revk/ESP32-IronMan/PCB/README.md

# PCBs for IronMan Suit

## Controller

Controller board

- Four LED driver outputs
- Two button inputs
- Stereo speaker outputs
- Stereo microphone (not needed for IronMan suit)
- Micro SD card slot
- On board LED
