revk/ESP32-IronMan/PCB/IronMan/README.md

# IronMan

These files are for use in [KiCad](https://www.kicad.org).

## Trademark

This is an open source project, but bear in mind you cannot sell boards bearing the Andrews & Arnold Ltd name, the A&A logo, the registered trademark AJK logo, or the GS1 allocated EANs assigned to Andrews & Arnold Ltd.

## Images

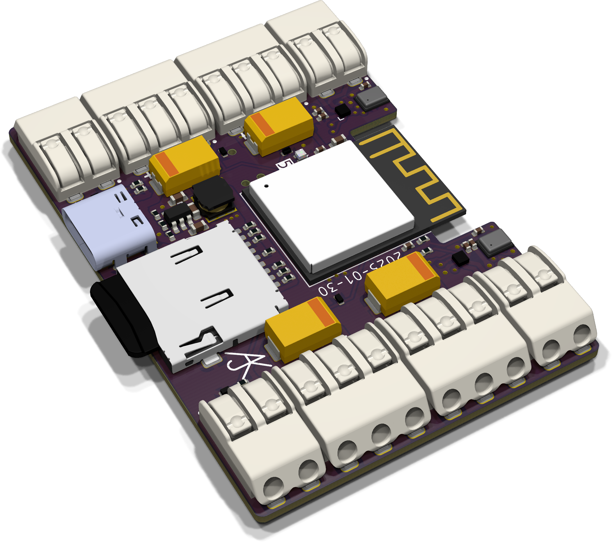
[picture p5: PCB/IronMan/IronMan-90.png]

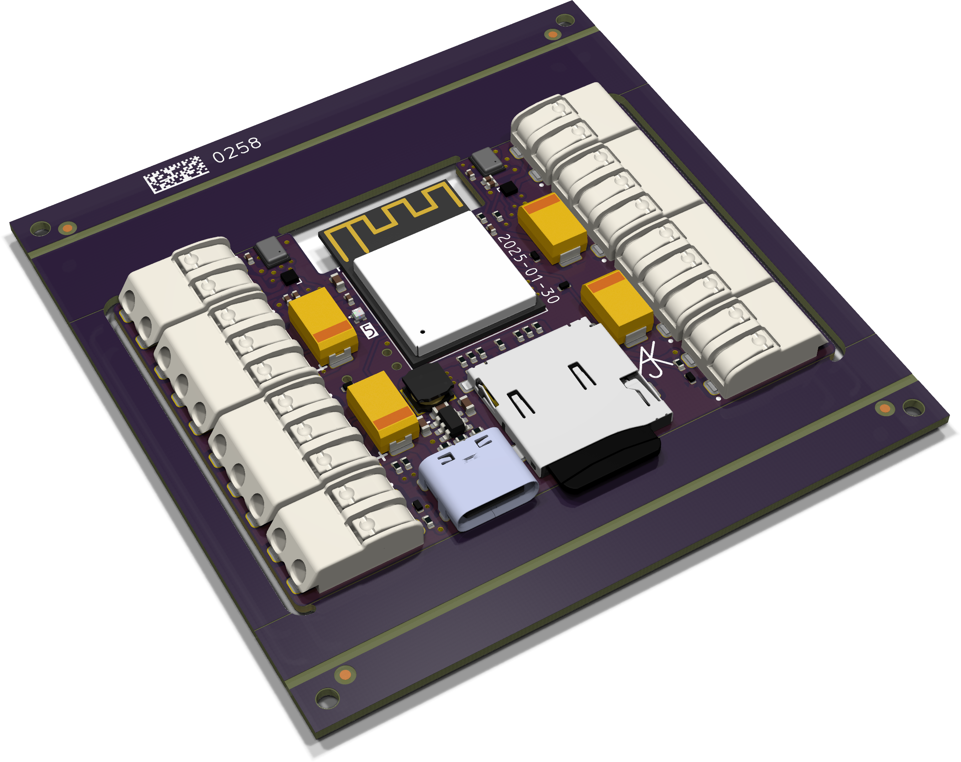
[picture p6: PCB/IronMan/IronMan-panel.png]
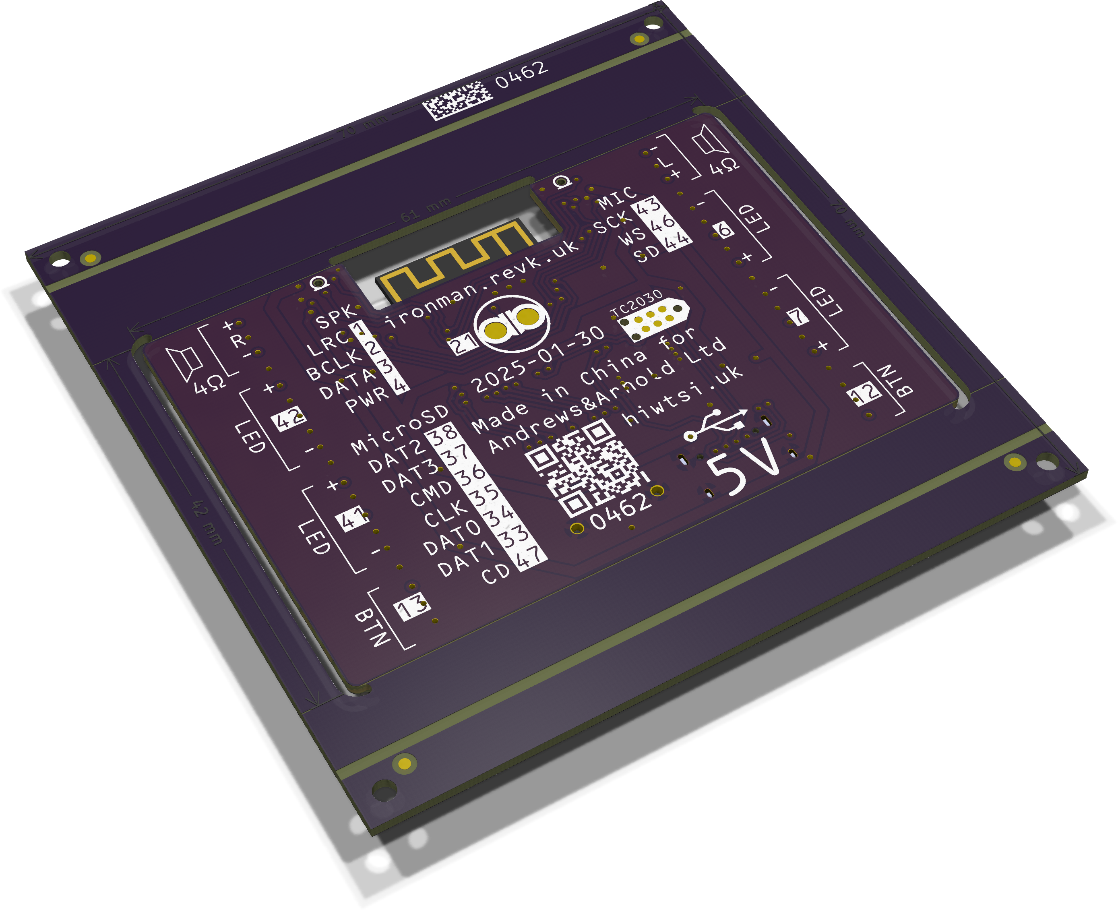
[picture p7: PCB/IronMan/IronMan-panel-bottom.png]


*Auto generated 2025-01-30T09:48:34*
