revk/ESP32-IronMan/PCB/Glove/README.md

# Glove

These files are for use in [KiCad](https://www.kicad.org).

## Trademark

This is an open source project, but bear in mind you cannot sell boards bearing the Andrews & Arnold Ltd name, the A&A logo, the registered trademark AJK logo, or the GS1 allocated EANs assigned to Andrews & Arnold Ltd.

## Images

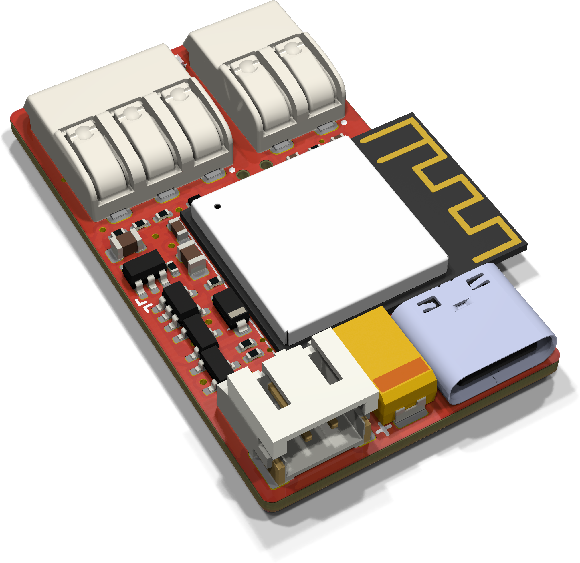
[picture p8: PCB/Glove/Glove-90.png]

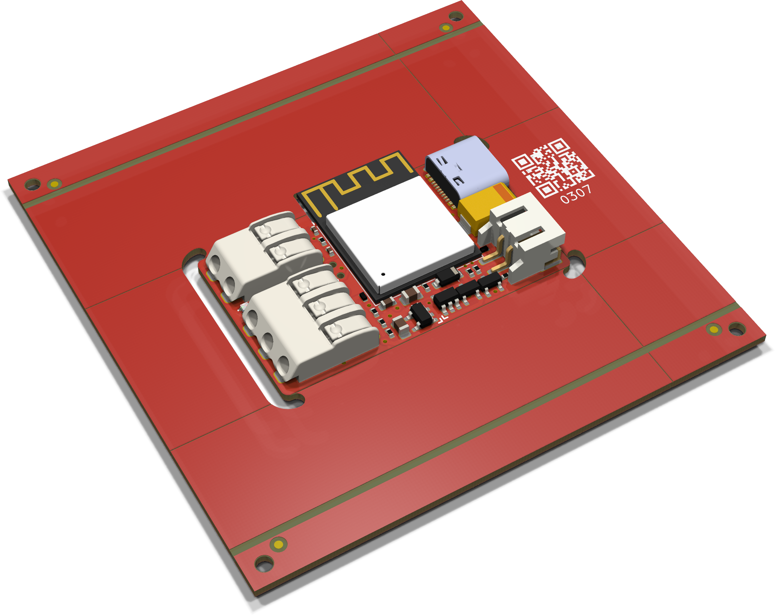
[picture p9: PCB/Glove/Glove-panel.png]
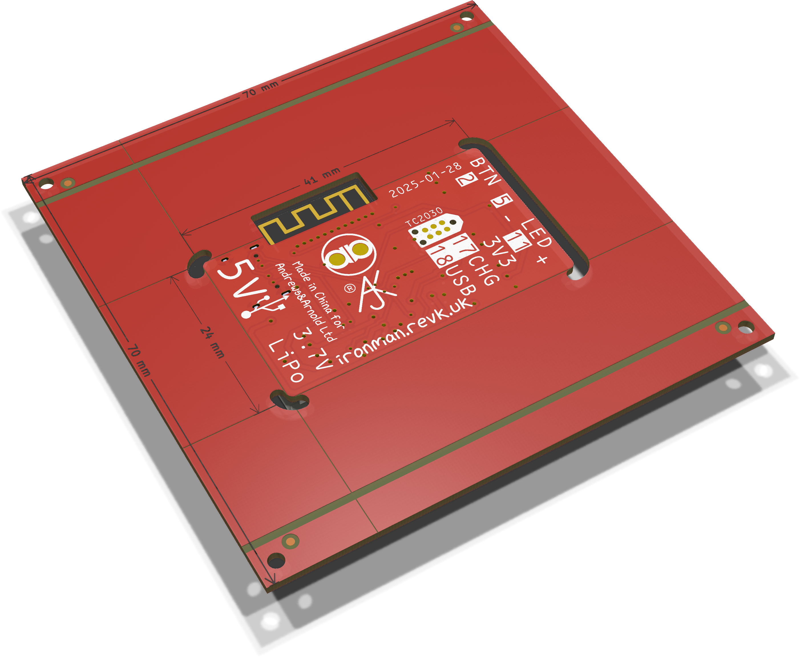
[picture p10: PCB/Glove/Glove-panel-bottom.png]


*Auto generated 2025-01-28T13:22:18*
