revk/ESP32-IronMan/PCB/IronMan/IronMan.stl

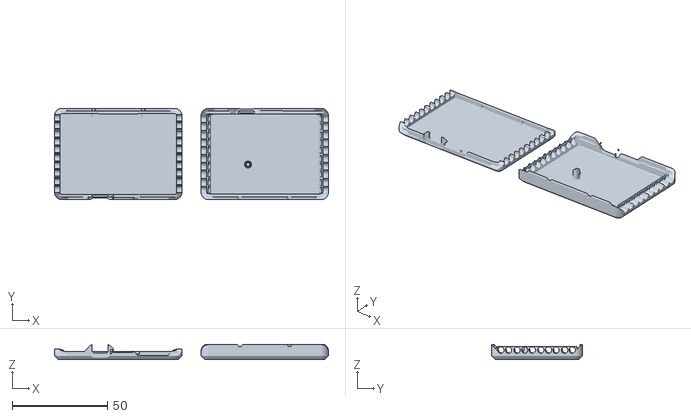
[picture p11: CAD file, 2025-01-13]
PCB/IronMan/IronMan.stl
144.0 x 48.0 x 7.99
