revk/ESP32-IronMan/PCB/Glove/Glove.kicad_pcb

## KiCad design PCB/Glove/Glove.kicad_pcb (2026-02-13)

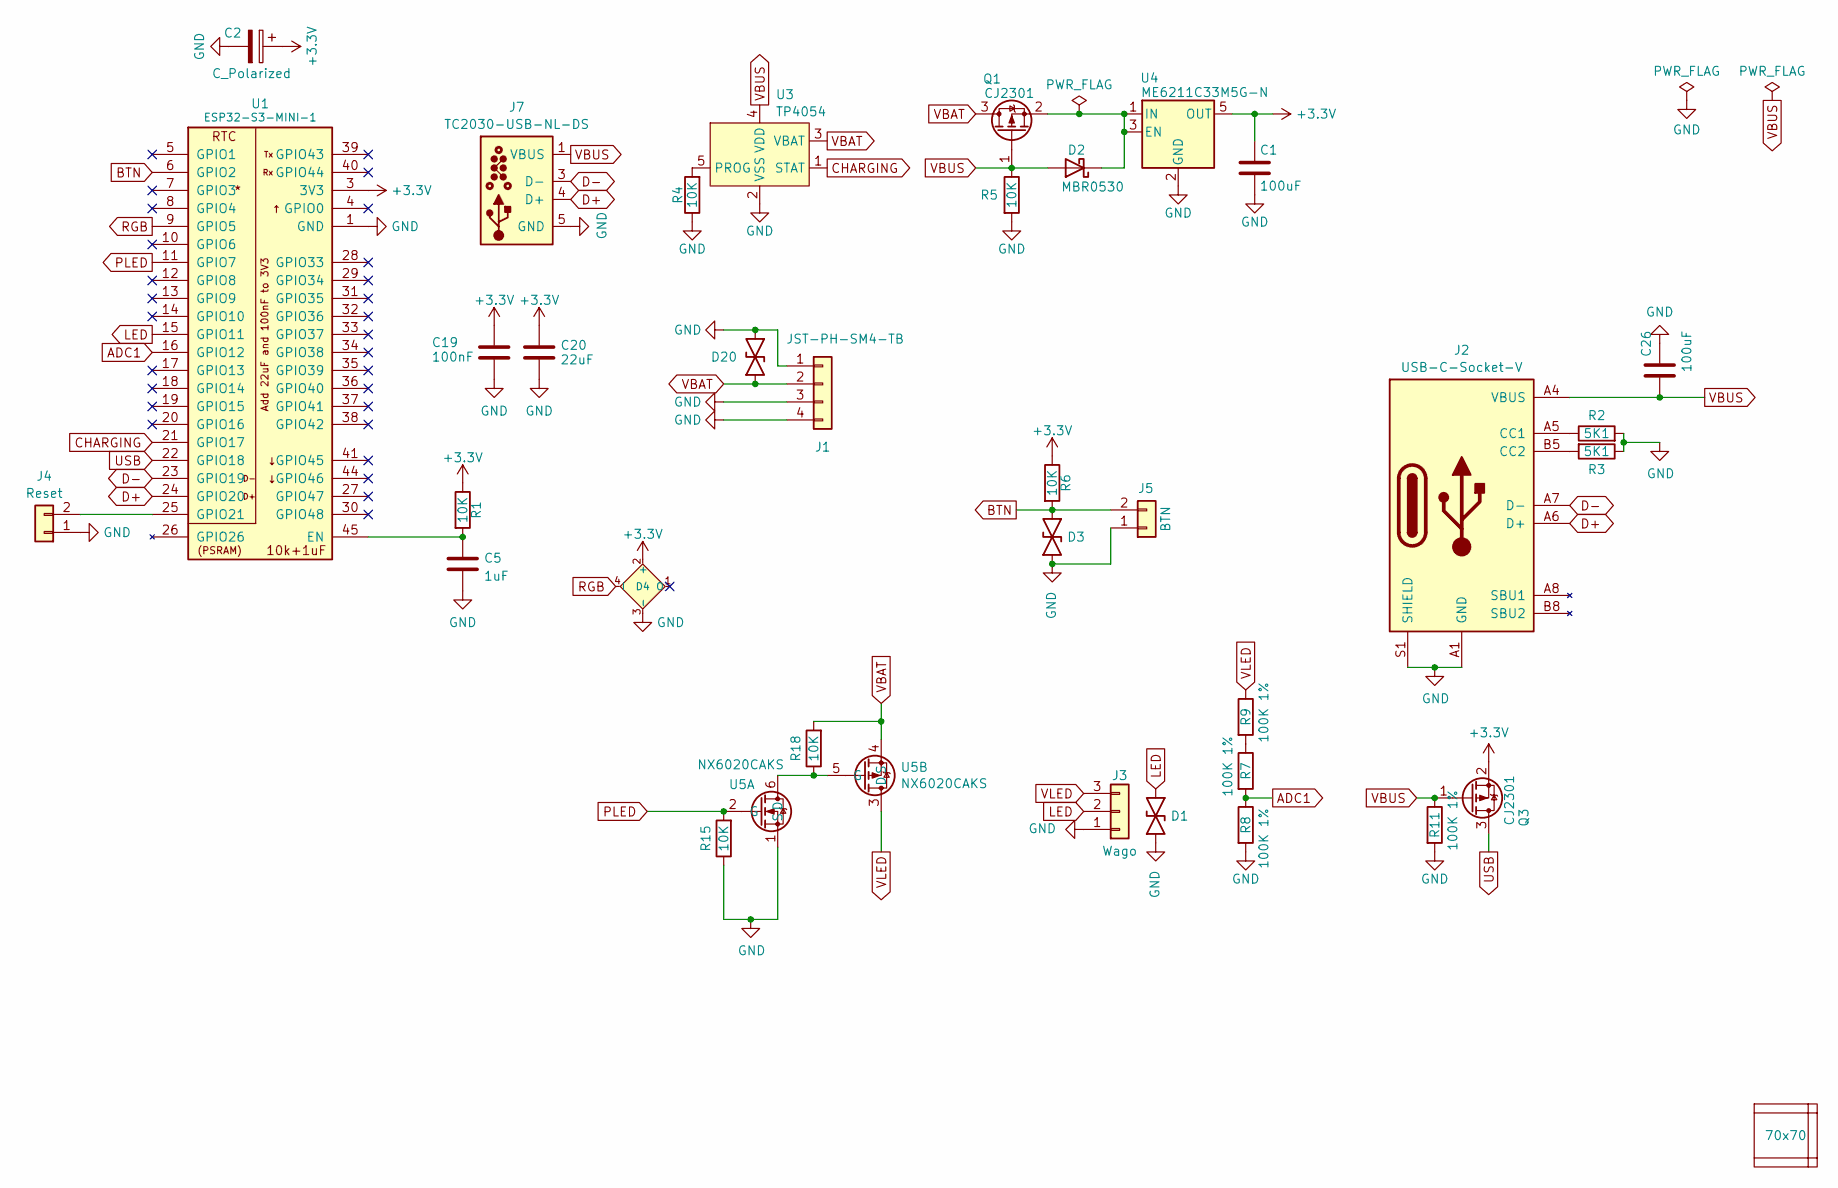
[picture p12: schematic Glove.kicad_sch, GPS reference]

Parts:
C1, C26: 100uF; C_0805; MPN C141660
C2: C_Polarized; CP_EIA-7343-31_Kemet-D; MPN C106188
C5: 1uF; C_0402
C19: 100nF; C_0402
C20: 22uF; C_0603
D1, D3, D20: DFN1006-2L; MPN C5137770
D2: MBR0530; D_SOD-123; MPN C5204746
D4: XL-1010RGBC-WS2812B; SMD1010; MPN C5349953
J1: JST-PH-SM4-TB; JST_PH_S2B-PH-SM4-TB_1x02-1MP_P2.00mm_Horizontal; MPN C295747
J2: USB-C-Socket-V; USB-C-Socket-H; MPN C709357
J3: Wago; WAGO-2060-453-998-404; MPN C2765056
J4: Reset; AA-Pad
J5: BTN; WAGO-2060-452-998-404; MPN C2765055
J7: TC2030-USB-NL-DS; Tag-Connect_TC2030-IDC-NL_2x03_P1.27mm_Vertical
PCB1: 70x70; PCB7070
Q1, Q3: CJ2301; SOT-23; MPN C5224170
R1, R4, R5, R6, R15, R18: 10K; R_0402
R2, R3: 5K1; R_0402
R7, R8, R9, R11: 100K 1%; R_0402; MPN C5139597
U1: ESP32-S3-MINI-1; MPN C3013941
U3: TP4054; SOT-23-5; MPN C668215
U4: ME6211C33M5G-N; SOT-23-5; MPN C82942
U5: NX6020CAKS; SOT-363_SC-70-6
V1, V2, V4: VCUT70N

Connections:
+3.3V: C1.1, C2.1, C19.1, C20.1, D4.2 (+), Q3.2 (S), R1.1, R6.1, U1.3 (3V3), U4.5 (OUT)
ADC1: R7.2, R8.1, U1.16 (GPIO12)
BTN: D3.2, J5.2, R6.2, U1.6 (GPIO2)
CHARGING: U1.21 (GPIO17), U3.1 (STAT)
D+: J2.A6 (D+), J2.B6 (D+), J7.4 (D+), U1.24 (GPIO20)
D-: J2.A7 (D-), J2.B7 (D-), J7.2 (NC), J7.3 (D-), J7.6 (NC), U1.23 (GPIO19)
GND: C1.2, C2.2, C5.2, C19.2, C20.2, C26.2, D1.1, D3.1, D4.3 (-), D20.1, J1.1, J1.3, J1.4, J2.A1 (GND), J2.A12 (GND), J2.B1 (GND), J2.B12 (GND), J2.S1 (SHIELD), J3.1, J4.1, J5.1, J7.5 (GND), R2.2, R3.1, R4.1, R5.2, R8.2, R11.2, R15.1, U1.1 (GND), U1.2 (GND), U1.42 (GND), U1.43 (GND), U1.46 (GND), U1.47 (GND), U1.48 (GND), U1.49 (GND), U1.50 (GND), U1.51 (GND), U1.52 (GND), U1.53 (GND), U1.54 (GND), U1.55 (GND), U1.56 (GND), U1.57 (GND), U1.58 (GND), U1.59 (GND), U1.60 (GND), U1.61 (GND), U1.62 (GND), U1.63 (GND), U1.64 (GND), U1.65 (GND), U3.2 (VSS), U4.2 (GND), U5.1 (S)
LED: D1.2, J3.2, U1.15 (GPIO11)
unnamed: D2.1 (K), Q1.2 (S), U4.1 (IN), U4.3 (EN)
unnamed: J2.A5 (CC1), R2.1
unnamed: J2.B5 (CC2), R3.2
unnamed: J4.2, U1.25 (GPIO21)
unnamed: R7.1, R9.2
unnamed: C5.1, R1.2, U1.45 (EN)
unnamed: R4.2, U3.5 (PROG)
unnamed: R18.1, U5.5 (G), U5.6 (D)
PLED: R15.2, U1.11 (GPIO7), U5.2 (G)
RGB: D4.4 (I), U1.9 (GPIO5)
USB: Q3.3 (D), U1.22 (GPIO18)
VBAT: D20.2, J1.2, Q1.3 (D), R18.2, U3.3 (VBAT), U5.4 (S)
VBUS: C26.1, D2.2 (A), J2.A4 (VBUS), J2.A9 (VBUS), J2.B4 (VBUS), J2.B9 (VBUS), J7.1 (VBUS), Q1.1 (G), Q3.1 (G), R5.1, R11.1, U3.4 (VDD)
VLED: J3.3, R9.1, U5.3 (D)

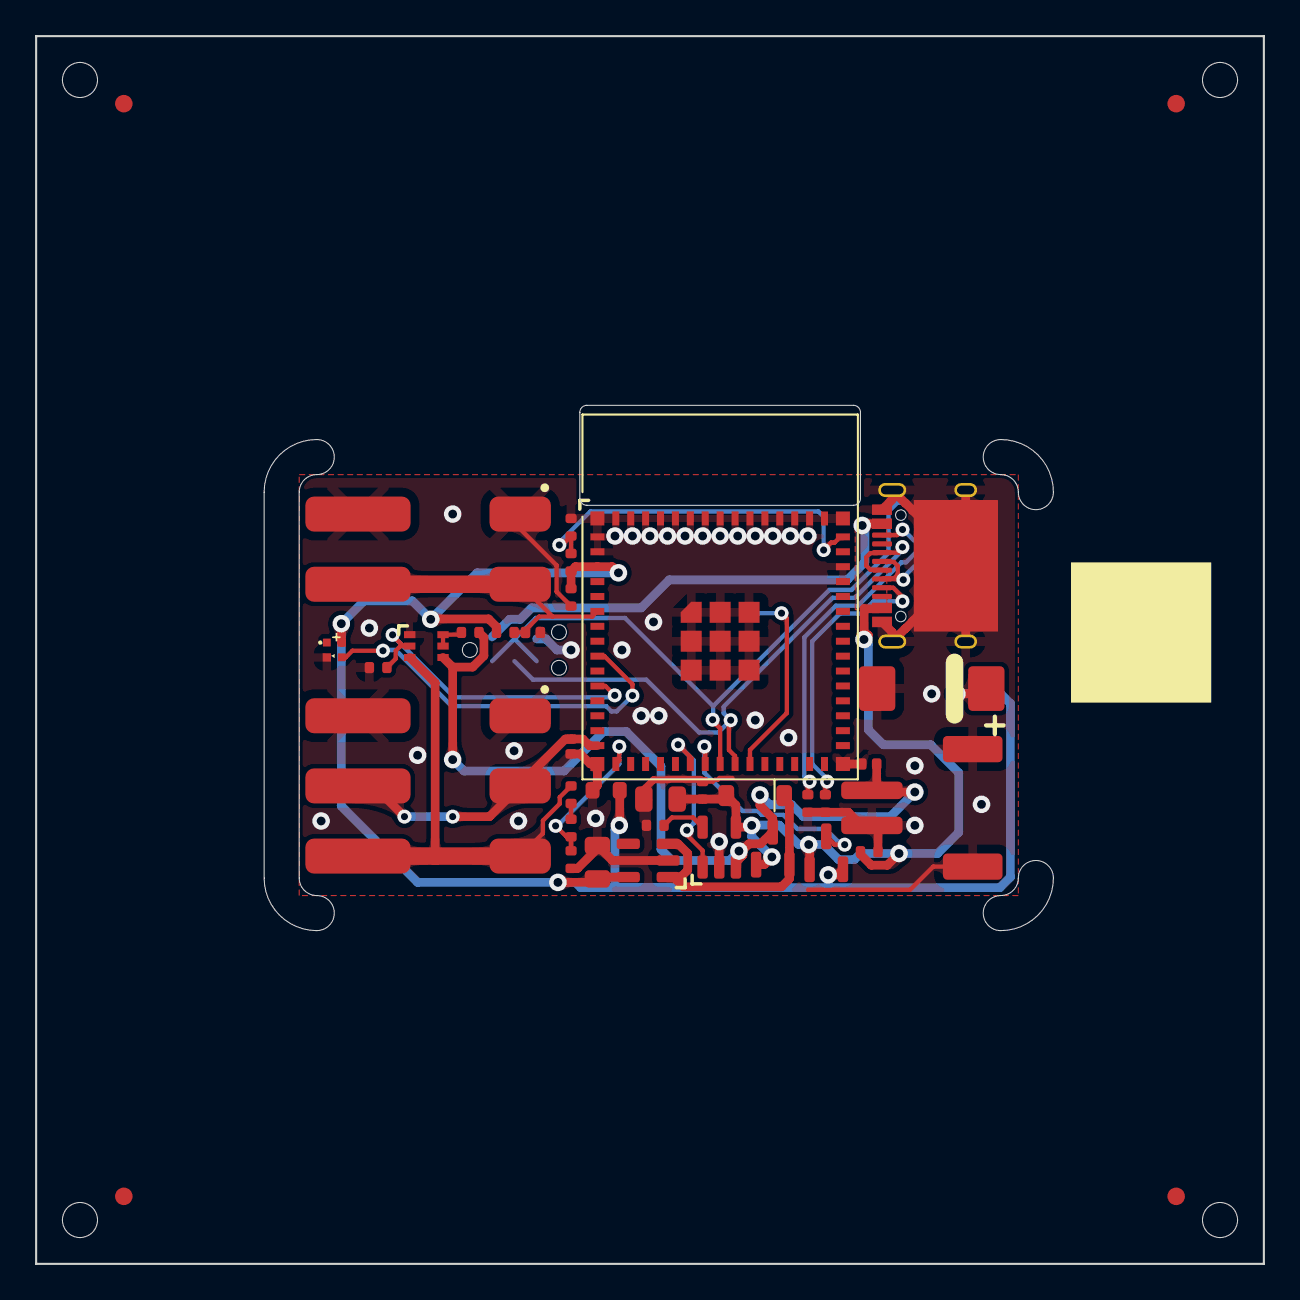
[picture p13: board Glove.kicad_pcb from above]

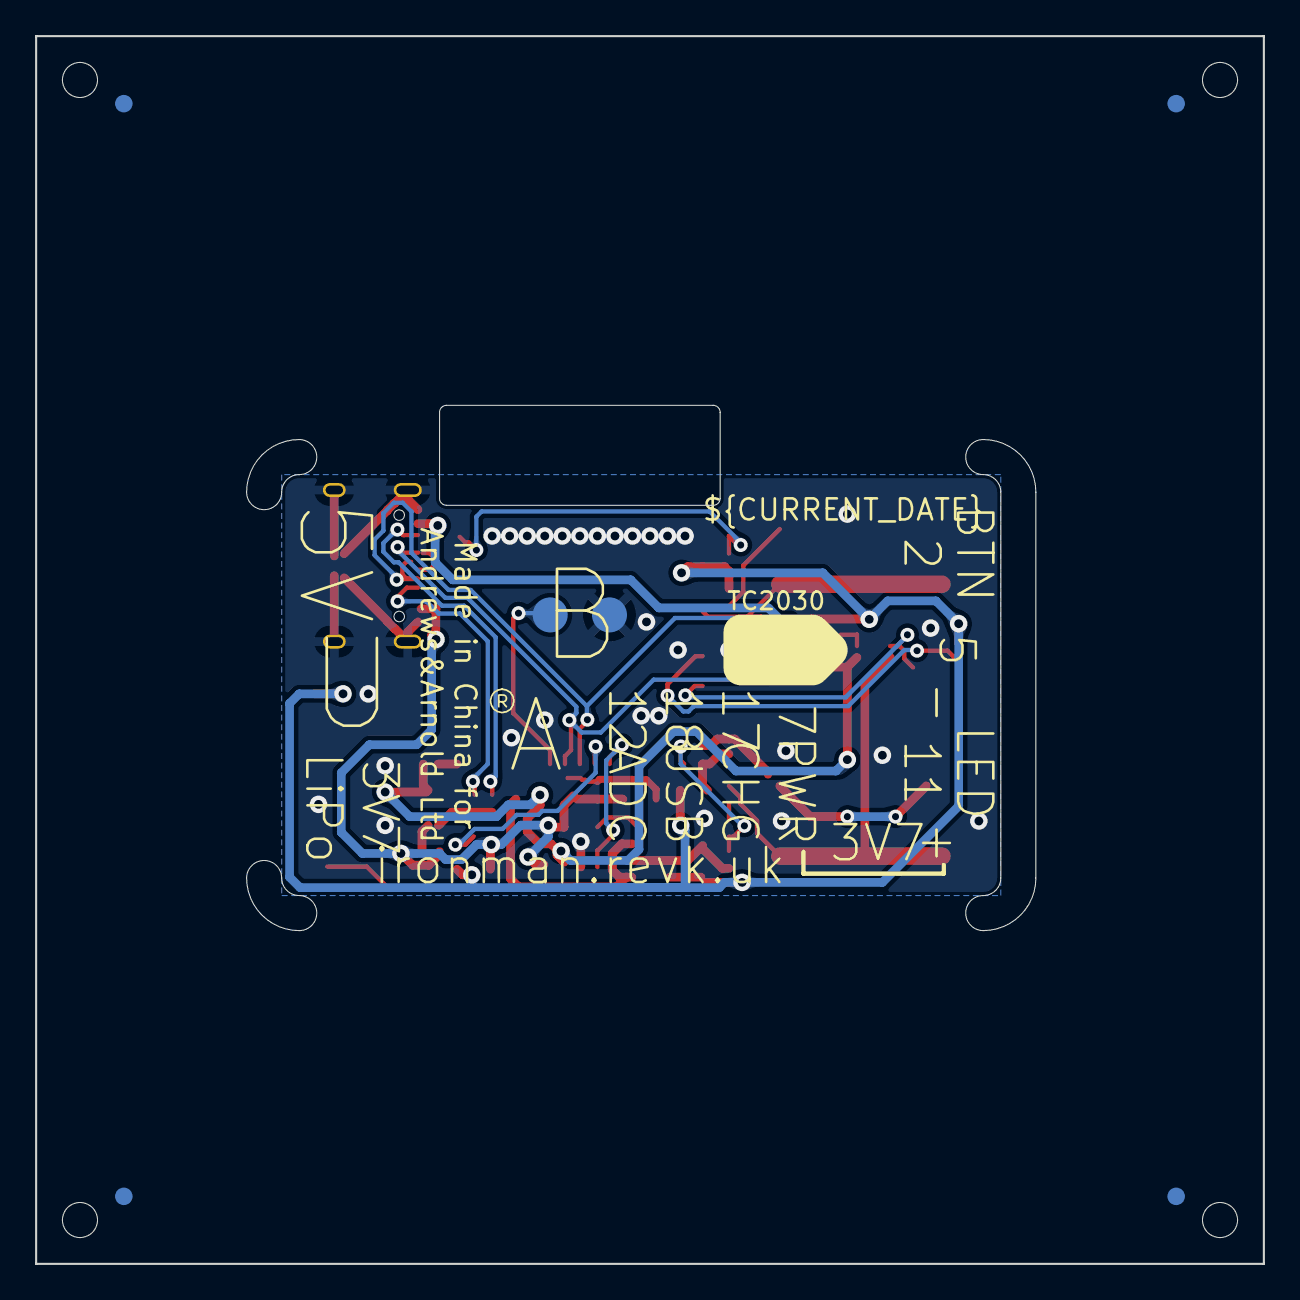
[picture p14: board Glove.kicad_pcb from below]

Board: 2 copper layers, 70.0 x 70.0 mm, 39 parts (3 on the bottom side), 22 nets.
