revk/ESP32-IronMan/PCB/IronMan/IronMan.kicad_pcb

## KiCad design PCB/IronMan/IronMan.kicad_pcb (2025-01-31)

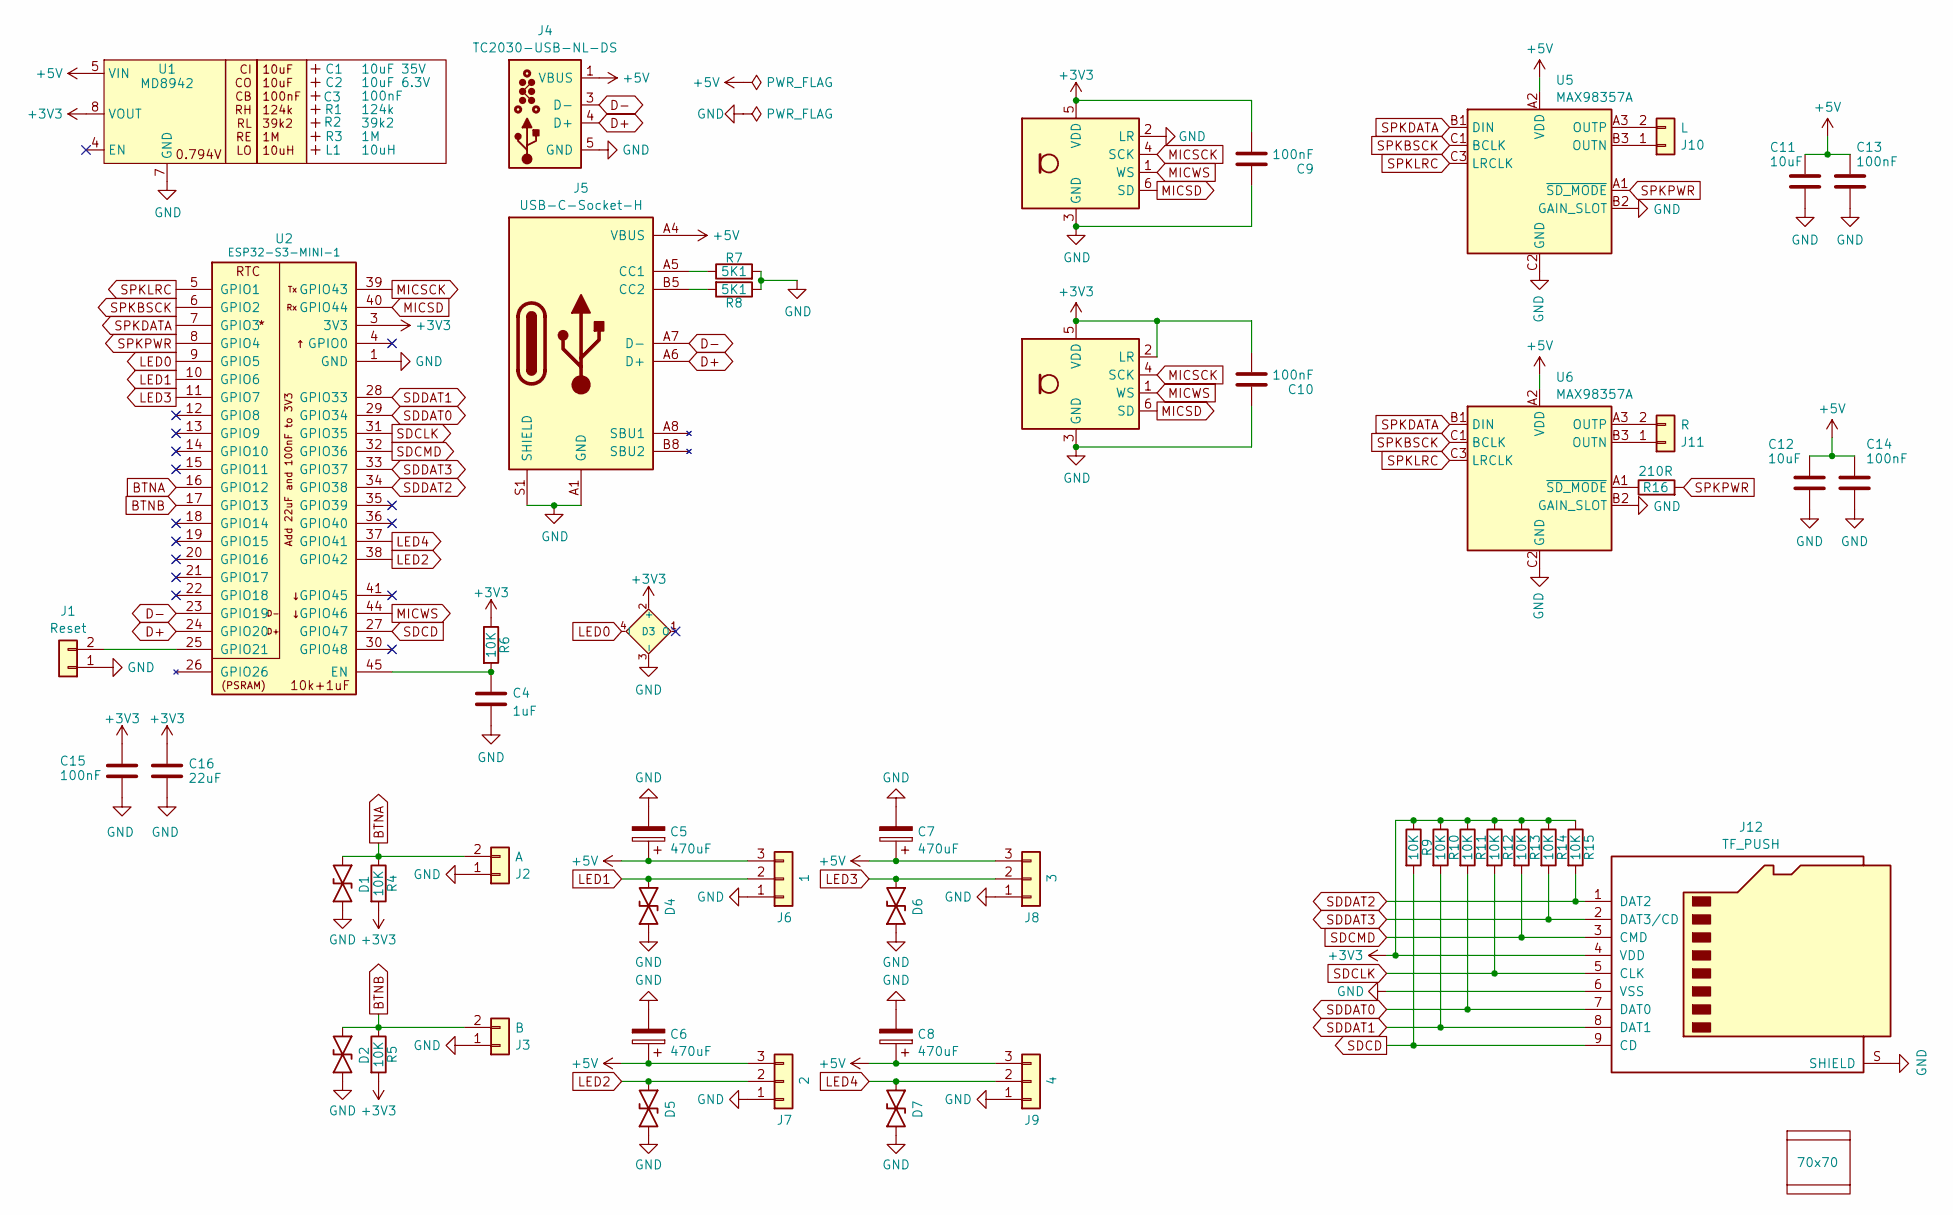
[picture p15: schematic IronMan.kicad_sch, IronMan Chest]

Parts:
C1: 10uF 35V; C_0603_; MPN C194427
C2: 10uF 6.3V; C_0603_; MPN C1691
C3: 100nF; C_0603_
C4: 1uF; C_0402
C5, C6, C7, C8: 470uF; CP_EIA-7343-31_Kemet-D; MPN C106188
C9, C10, C13, C14, C15: 100nF; C_0402
C11, C12: 10uF; C_0402; MPN C15525
C16: 22uF; C_0603
D1, D2, D4, D5, D6, D7: DFN1006-2L; MPN C5137770
D3: XL-1010RGBC-WS2812B; SMD1010; MPN C5349953
J1: Reset; AA-Pad
J2: A; WAGO-2060-452-998-404; MPN C2765055
J3: B; WAGO-2060-452-998-404; MPN C2765055
J4: TC2030-USB-NL-DS; Tag-Connect_TC2030-IDC-NL_2x03_P1.27mm_Vertical
J5: USB-C-Socket-H; MPN C709357
J6: 1; WAGO-2060-453-998-404; MPN C2765056
J7: 2; WAGO-2060-453-998-404; MPN C2765056
J8: 3; WAGO-2060-453-998-404; MPN C2765056
J9: 4; WAGO-2060-453-998-404; MPN C2765056
J10: L; WAGO-2060-452-998-404; MPN C2765055
J11: R; WAGO-2060-452-998-404; MPN C2765055
J12: TF_PUSH; MPN C393941
L1: 10uH; L_4x4_
PCB1: 70x70; PCB7070
R1: 124k; R_0402_
R2: 39k2; R_0402_
R3: 1M; R_0402_
R4, R5, R6, R9, R10, R11, R12, R13, R14, R15: 10K; R_0402
R7, R8: 5K1; R_0402
R16: 210R; R_0402; MPN C226891
U1: MD8942; SOT-23-6-MD8942; MPN C2684786
U2: ESP32-S3-MINI-1; MPN C3013941
U3: L; ICS43434_MEMS_Mic; MPN C5656610
U4: R; ICS43434_MEMS_Mic; MPN C5656610
U5, U6: MAX98357A; WLP-1.437mmx1.347mm-0.21mm-ball; MPN C2682619
V2, V3: VCUT70N

Connections:
+3V3: C9.2, C10.2, C15.1, C16.1, D3.2 (+), J12.4 (VDD), R4.2, R5.2, R6.1, R9.1, R10.1, R11.1, R12.1, R13.1, R14.1, R15.1, U1.8 (VOUT), U2.3 (3V3), U3.5 (VDD), U4.2 (LR), U4.5 (VDD)
+5V: C5.1, C6.1, C7.1, C8.1, C11.1, C12.1, C13.1, C14.1, J4.1 (VBUS), J5.A4 (VBUS), J5.A9 (VBUS), J5.B4 (VBUS), J5.B9 (VBUS), J6.3, J7.3, J8.3, J9.3, U1.5 (VIN), U5.A2 (VDD), U6.A2 (VDD)
BTNA: D1.1, J2.2, R4.1, U2.16 (GPIO12)
BTNB: D2.1, J3.2, R5.1, U2.17 (GPIO13)
D+: J4.4 (D+), J5.A6 (D+), J5.B6 (D+), U2.24 (GPIO20)
D-: J4.2 (NC), J4.3 (D-), J4.6 (NC), J5.A7 (D-), J5.B7 (D-), U2.23 (GPIO19)
GND: C4.2, C5.2, C6.2, C7.2, C8.2, C9.1, C10.1, C11.2, C12.2, C13.2, C14.2, C15.2, C16.2, D1.2, D2.2, D3.3 (-), D4.2, D5.2, D6.2, D7.2, J1.1, J2.1, J3.1, J4.5 (GND), J5.A1 (GND), J5.A12 (GND), J5.B1 (GND), J5.B12 (GND), J5.S1 (SHIELD), J6.1, J7.1, J8.1, J9.1, J12.6 (VSS), J12.S (SHIELD), R7.2, R8.1, U1.2 (GND), U1.7 (GND), U2.1 (GND), U2.2 (GND), U2.42 (GND), U2.43 (GND), U2.46 (GND), U2.47 (GND), U2.48 (GND), U2.49 (GND), U2.50 (GND), U2.51 (GND), U2.52 (GND), U2.53 (GND), U2.54 (GND), U2.55 (GND), U2.56 (GND), U2.57 (GND), U2.58 (GND), U2.59 (GND), U2.60 (GND), U2.61 (GND), U2.62 (GND), U2.63 (GND), U2.64 (GND), U2.65 (GND), U3.2 (LR), U3.3 (GND), U4.3 (GND), U5.B2 (GAIN_SLOT), U5.C2 (GND), U6.B2 (GAIN_SLOT), U6.C2 (GND)
LED0: D3.4 (I), U2.9 (GPIO5)
LED1: D4.1, J6.2, U2.10 (GPIO6)
LED2: D5.1, J7.2, U2.38 (GPIO42)
LED3: D6.1, J8.2, U2.11 (GPIO7)
LED4: D7.1, J9.2, U2.37 (GPIO41)
MICSCK: U2.39 (GPIO43), U3.4 (SCK), U4.4 (SCK)
MICSD: U2.40 (GPIO44), U3.6 (SD), U4.6 (SD)
MICWS: U2.44 (GPIO46), U3.1 (WS), U4.1 (WS)
unnamed: J1.2, U2.25 (GPIO21)
unnamed: J5.A5 (CC1), R7.1
unnamed: J5.B5 (CC2), R8.2
unnamed: J10.1, U5.B3 (OUTN)
unnamed: J10.2, U5.A3 (OUTP)
unnamed: J11.1, U6.B3 (OUTN)
unnamed: J11.2, U6.A3 (OUTP)
unnamed: C4.1, R6.2, U2.45 (EN)
unnamed: R16.1, U6.A1 (~SD_MODE)
SDCD: J12.9 (CD), R9.2, U2.27 (GPIO47)
SDCLK: J12.5 (CLK), R12.2, U2.31 (GPIO35)
SDCMD: J12.3 (CMD), R13.2, U2.32 (GPIO36)
SDDAT0: J12.7 (DAT0), R11.2, U2.29 (GPIO34)
SDDAT1: J12.8 (DAT1), R10.2, U2.28 (GPIO33)
SDDAT2: J12.1 (DAT2), R15.2, U2.34 (GPIO38)
SDDAT3: J12.2 (DAT3/CD), R14.2, U2.33 (GPIO37)
SPKBSCK: U2.6 (GPIO2), U5.C1 (BCLK), U6.C1 (BCLK)
SPKDATA: U2.7 (GPIO3), U5.B1 (DIN), U6.B1 (DIN)
SPKLRC: U2.5 (GPIO1), U5.C3 (LRCLK), U6.C3 (LRCLK)
SPKPWR: R16.2, U2.8 (GPIO4), U5.A1 (~SD_MODE)

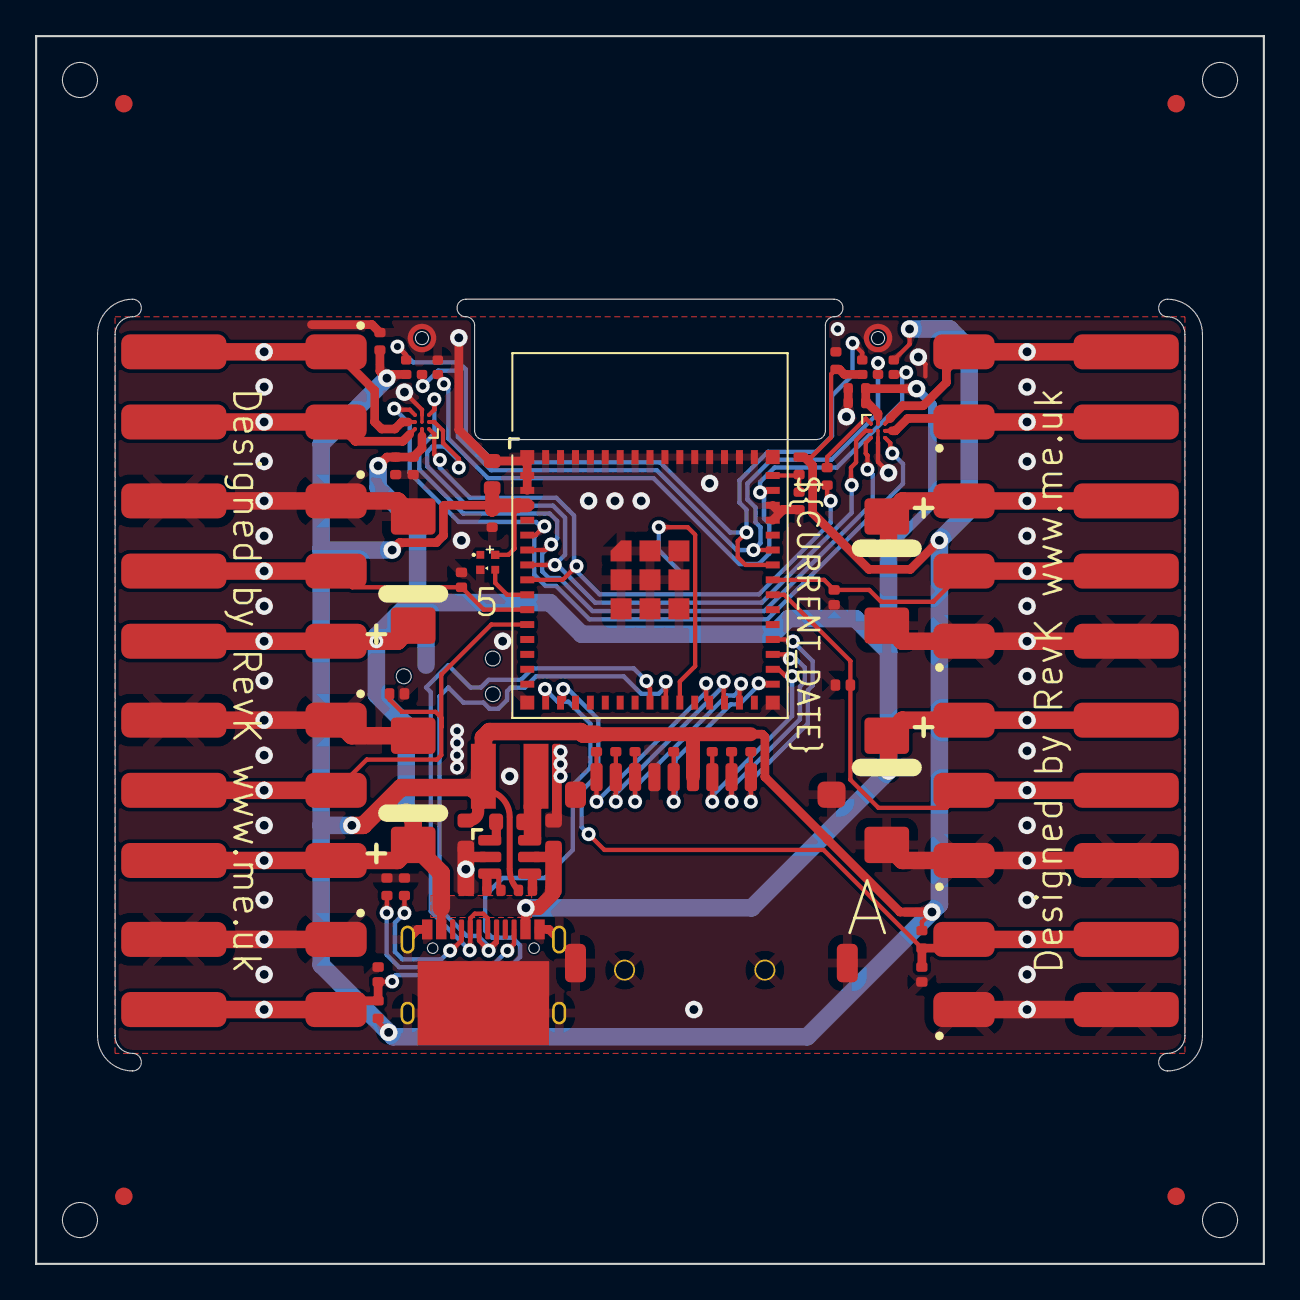
[picture p16: board IronMan.kicad_pcb from above]

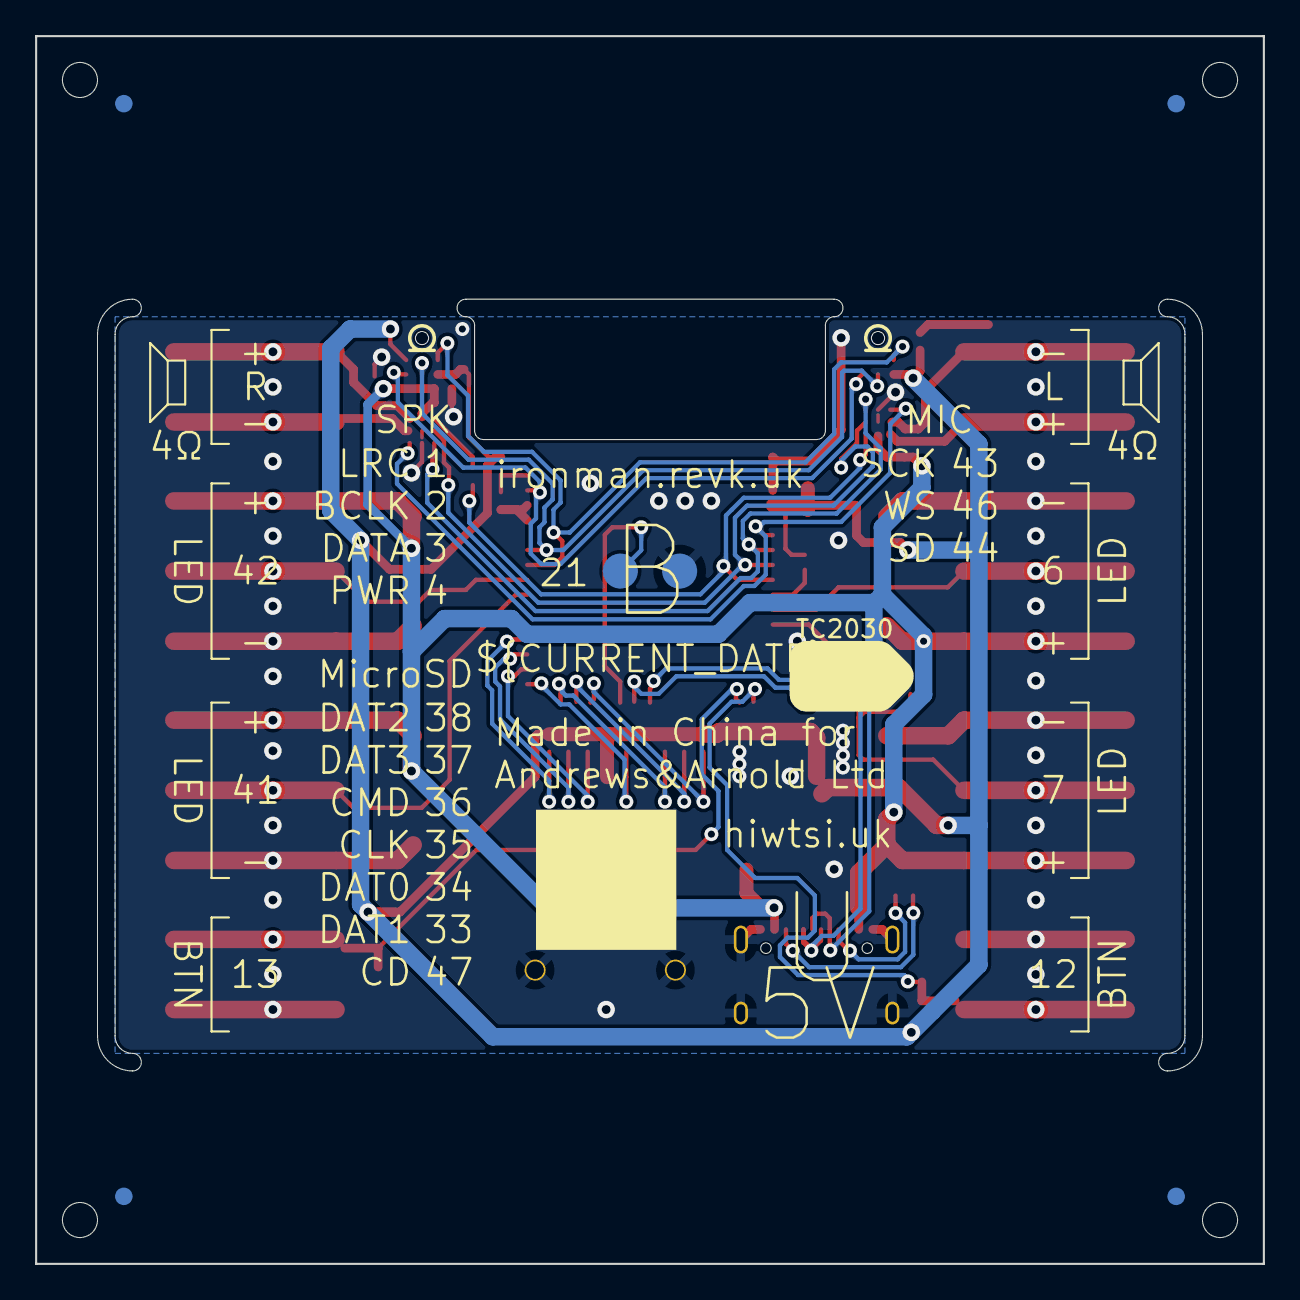
[picture p17: board IronMan.kicad_pcb from below]

Board: 2 copper layers, 70.0 x 70.0 mm, 61 parts (2 on the bottom side), 35 nets.
