revk/ESP32-IronMan/(commit log)

2024-04-21 LED strip init
2024-08-25 More LEDs
2025-01-10 Started Chest board
    [Chest.kicad_pcb, Chest.kicad_sch]
2025-01-10 Start on design
    [Chest.kicad_pcb, bom.csv, designators.csv, positions.csv]
2025-01-10 Bigger caps
    [Chest.kicad_pcb, Chest.kicad_sch, bom.csv, designators.csv, positions.csv]
2025-01-11 Tweak tracks
    [Chest.kicad_pcb, Chest.kicad_sch, bom.csv]
2025-01-12 New render
    [Chest.kicad_pcb, Chest.kicad_sch]
2025-01-13 New images
    [IronMan.scad, IronMan.stl]
2025-01-16 Ready to track
    [Glove.kicad_pcb, Glove.kicad_sch, bom.csv, designators.csv, positions.csv]
2025-01-16 Ready to order
    [Glove.kicad_pcb, Glove.kicad_sch, bom.csv, positions.csv]
2025-01-17 Process rails
    [Glove.kicad_pcb, IronMan.kicad_pcb, designators.csv, positions.csv]
2025-01-21 Tweak - 5V MAX
    [Glove.kicad_pcb, IronMan.kicad_pcb, IronMan.kicad_sch, bom.csv]
2025-01-21 No point
    [IronMan.scad]
2025-01-22 Ready to re-order
    [IronMan.kicad_pcb, bom.csv, positions.csv]
2025-01-22 Library update
    [IronMan.kicad_pcb, IronMan.kicad_sch, bom.csv, positions.csv]
2025-01-22 Basic LED
2025-01-22 Pos files
    [IronMan.kicad_pcb, IronMan.kicad_sch, bom.csv, positions.csv]
2025-01-23 PCB Update
    [Glove.kicad_pcb, Glove.kicad_sch, IronMan.kicad_pcb, IronMan.kicad_sch, bom.csv, positions.csv]
2025-01-24 new LED colour logic
2025-01-25 Generic button logic
2025-01-26 Power down logic
2025-01-26 Better power on/off logic
2025-01-28 Image eupdates
    [IronMan.kicad_pcb, IronMan.kicad_sch, bom.csv, positions.csv]
2025-01-31 PWM shutdown
2025-02-02 Tried periodic wake, did not work
    [IronMan.c]
2025-02-10 Charger logic
2025-02-10 Charge logic
2025-03-14 Added ADC and PWR
    [Glove.kicad_pcb, Glove.kicad_sch, bom.csv, designators.csv, positions.csv]
